xhero/powerbook100-airtalk/PowerBook100_AirTalk.kicad_pcb

## KiCad design PowerBook100_AirTalk.kicad_pcb (2023-10-18)

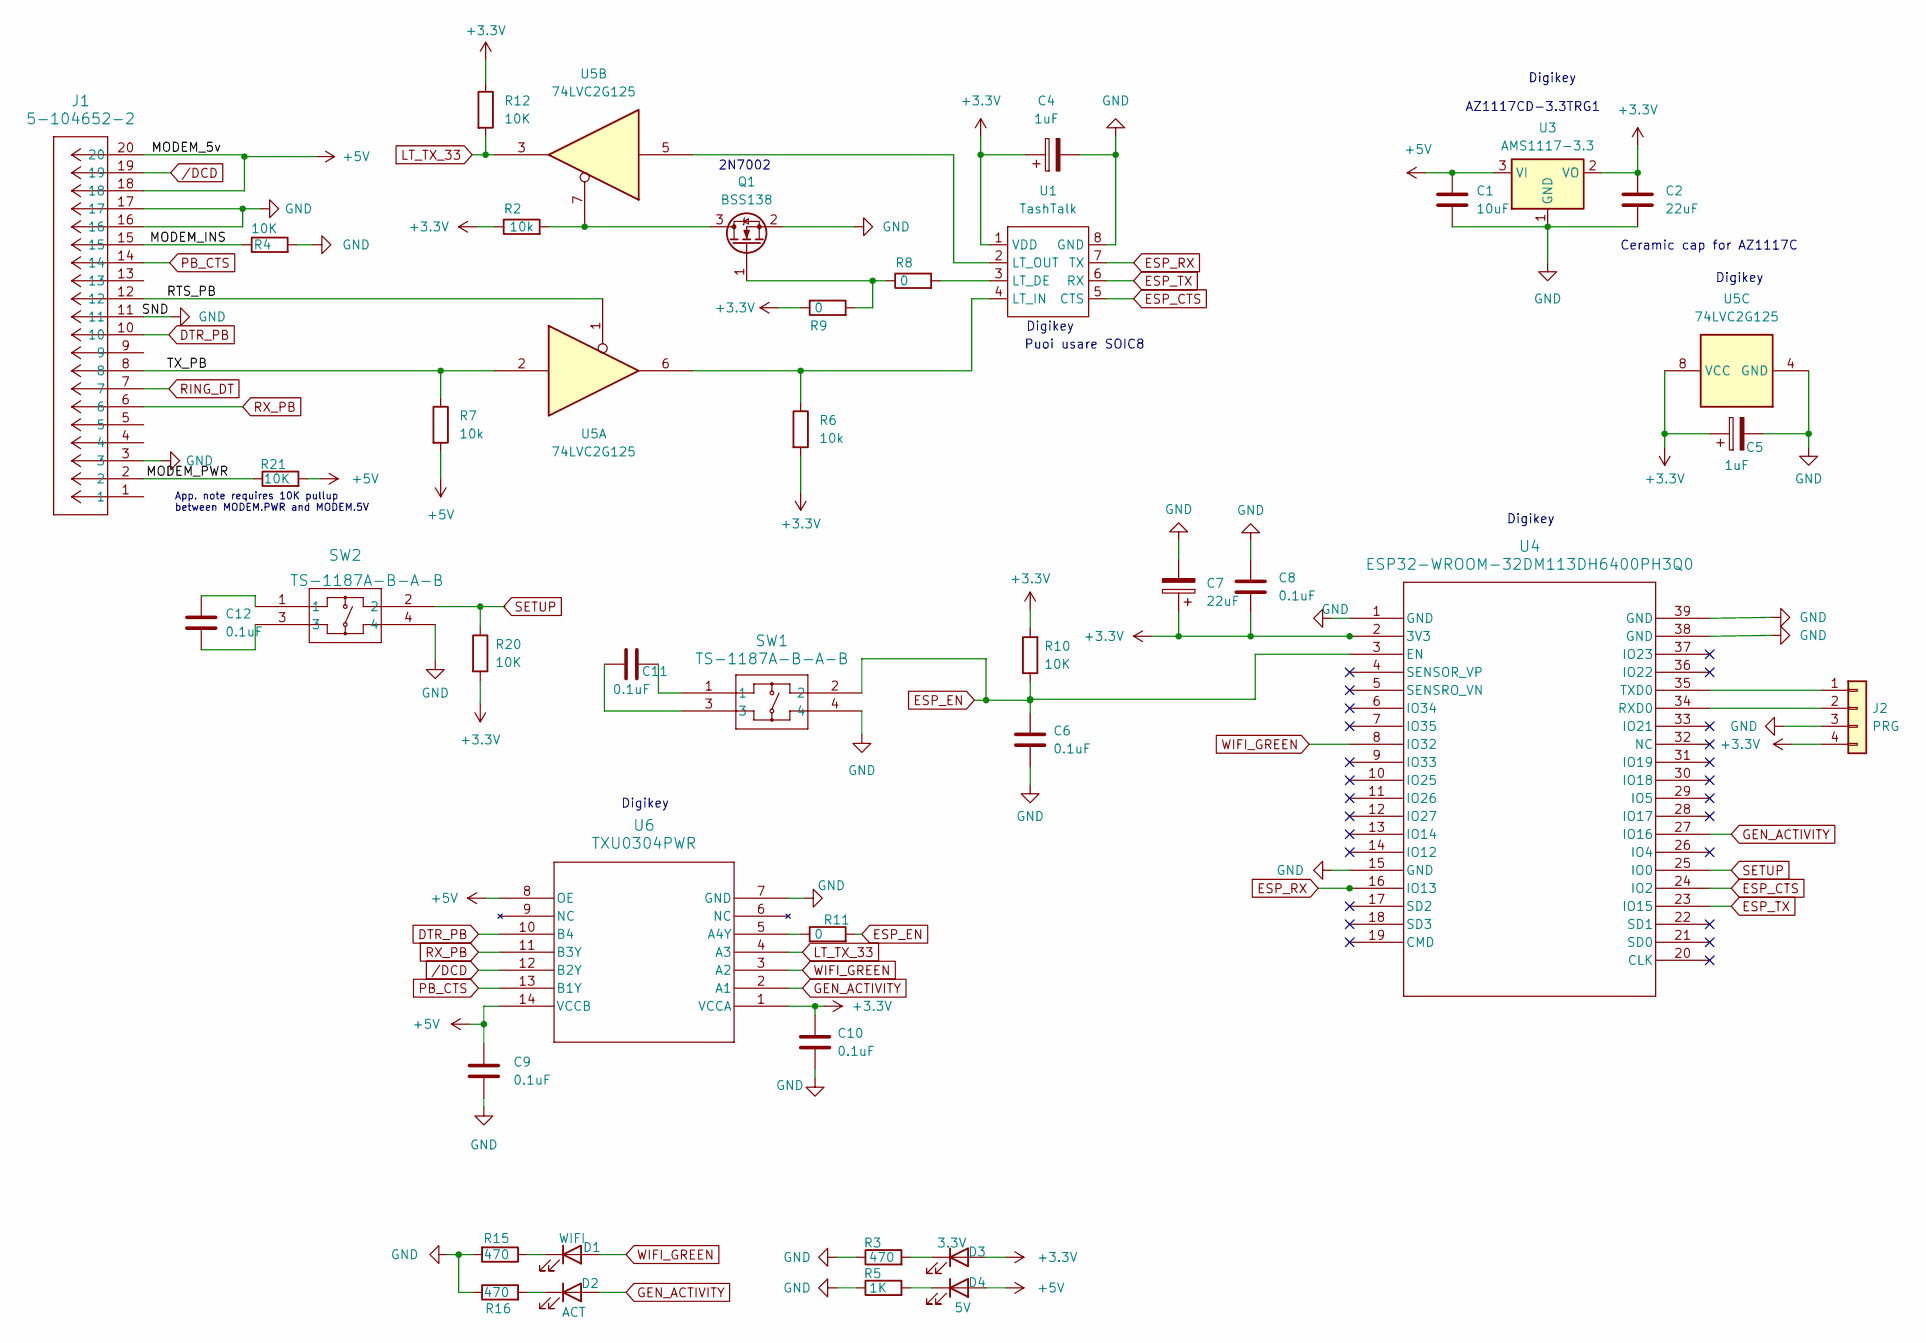
[picture p1: schematic PowerBook100_AirTalk.kicad_sch]

Parts:
C1: 10uF; C_0805_2012Metric
C2: 22uF; C_0805_2012Metric
C4, C5: 1uF; C_1206_3216Metric
C6, C8, C9, C10: 0.1uF; C_0805_2012Metric
C7: 22uF; C_1206_3216Metric
C11, C12: 0.1uF; C_1206_3216Metric
D1: WIFI; LED_0805_2012Metric
D2: ACT; LED_0805_2012Metric
D3: 3.3V; LED_0805_2012Metric
D4: 5V; LED_0805_2012Metric
J1: 5-104652-2; CONN_5-104652-2_TYCO
J2: PRG; PinHeader_1x04_P1.00mm_Vertical_SMD_Pin1Right
Q1: BSS138; SOT-23
R2, R6, R7: 10k; R_0805_2012Metric
R3, R15, R16: 470; R_0805_2012Metric
R4, R10, R12, R20, R21: 10K; R_0805_2012Metric
R5: 1K; R_0805_2012Metric
R8, R9, R11: 0; R_0805_2012Metric
SW1, SW2: TS-1187A-B-A-B; SW_Push_1P1T_XKB_TS-1187A
U1: TashTalk; SOIC-8_3.9x4.9mm_P1.27mm
U3: AMS1117-3.3; TO-252-3_TabPin2
U4: ESP32-WROOM-32DM113DH6400PH3Q0; ESP32-WROOM-32D
U5: 74LVC2G125; TSSOP-8_3x3mm_P0.65mm
U6: TXU0304PWR; TSSOP14_PW_TEX

Connections:
+3.3V: C2.1, C4.1, C5.1, C7.1, C8.2, C10.1, D3.2 (A), J2.4, R2.1, R6.2, R9.1, R10.2, R12.1, R20.2, U1.1 (VDD), U3.2 (VO), U4.2 (3V3), U5.8 (VCC), U6.1 (VCCA)
+5V: C1.1, C9.1, D4.2 (A), J1.18, J1.20, R7.2, R21.2, U3.3 (VI), U6.8 (OE), U6.14 (VCCB)
/MODEM_INS: J1.15, R4.1
/MODEM_PWR: J1.2, R21.1
/RTS_PB: J1.12, U5.1
/TX_PB: J1.8, R7.1, U5.2
DTR_PB: J1.10, U6.10 (B4)
ESP_CTS: U1.5 (CTS), U4.24 (IO2)
ESP_EN: C6.2, R10.1, R11.2, SW1.2, U4.3 (EN)
ESP_RX: U1.7 (TX), U4.16 (IO13)
ESP_TX: U1.6 (RX), U4.23 (IO15)
GEN_ACTIVITY: D2.2 (A), U4.27 (IO16), U6.2 (A1)
GND: C1.2, C2.2, C4.2, C5.2, C6.1, C7.2, C8.1, C9.2, C10.2, J1.3, J1.11, J1.16, J1.17, J2.3, Q1.2 (S), R3.1, R4.2, R5.1, R15.2, R16.1, SW1.4, SW2.4, U1.8 (GND), U3.1 (GND), U4.1 (GND), U4.15 (GND), U4.38 (GND), U4.39 (GND), U5.4 (GND), U6.7 (GND)
LT_TX_33: R12.2, U5.3, U6.4 (A3)
unnamed: C11.1, SW1.3
unnamed: C11.2, SW1.1
unnamed: C12.1, SW2.1
unnamed: C12.2, SW2.3
unnamed: D1.1 (K), R15.1
unnamed: D2.1 (K), R16.2
unnamed: D3.1 (K), R3.2
unnamed: D4.1 (K), R5.2
unnamed: J2.1, U4.35 (TXD0)
unnamed: J2.2, U4.34 (RXD0)
unnamed: Q1.3 (D), R2.2, U5.7
unnamed: Q1.1 (G), R8.1, R9.2
unnamed: R8.2, U1.3 (LT_DE)
unnamed: R6.1, U1.4 (LT_IN), U5.6
unnamed: U1.2 (LT_OUT), U5.5
unnamed: R11.1, U6.5 (A4Y)
PB_CTS: J1.14, U6.13 (B1Y)
RING_DT: J1.7
RX_PB: J1.6, U6.11 (B3Y)
SETUP: R20.1, SW2.2, U4.25 (IO0)
WIFI_GREEN: D1.2 (A), U4.8 (IO32), U6.3 (A2)
/DCD: J1.19, U6.12 (B2Y)

Notes on the sheet:
Digikey
Puoi usare SOIC8
App. note requires 10K pullup between MODEM.PWR and MODEM.5V
AZ1117CD-3.3TRG1
2N7002
Ceramic cap for AZ1117C

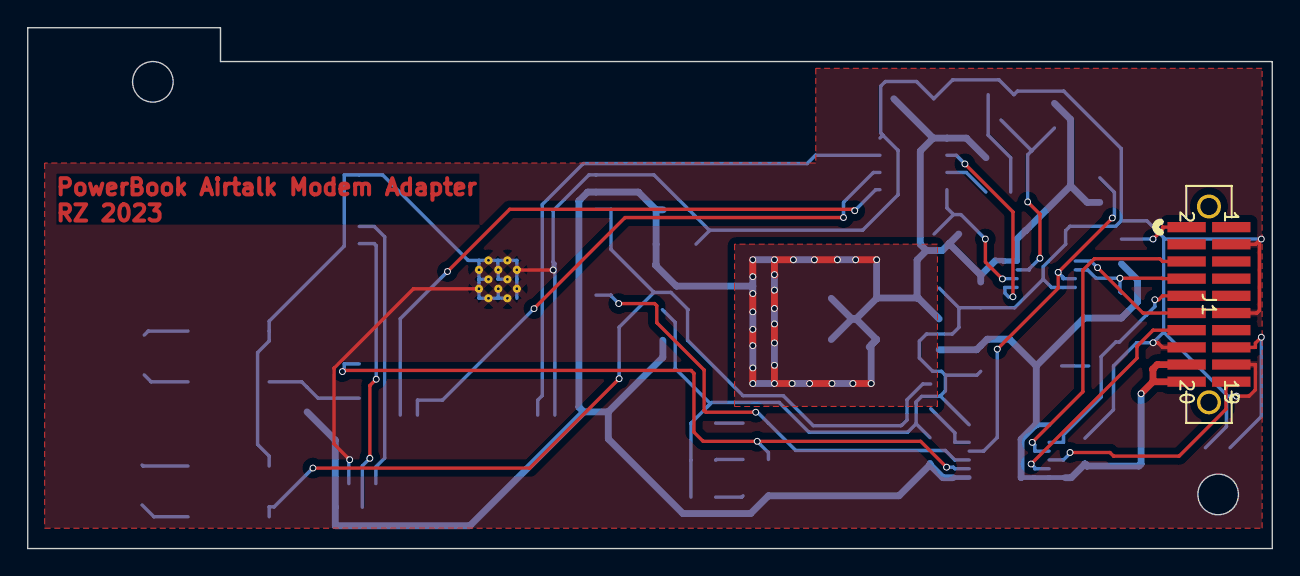
[picture p2: board PowerBook100_AirTalk.kicad_pcb from above]

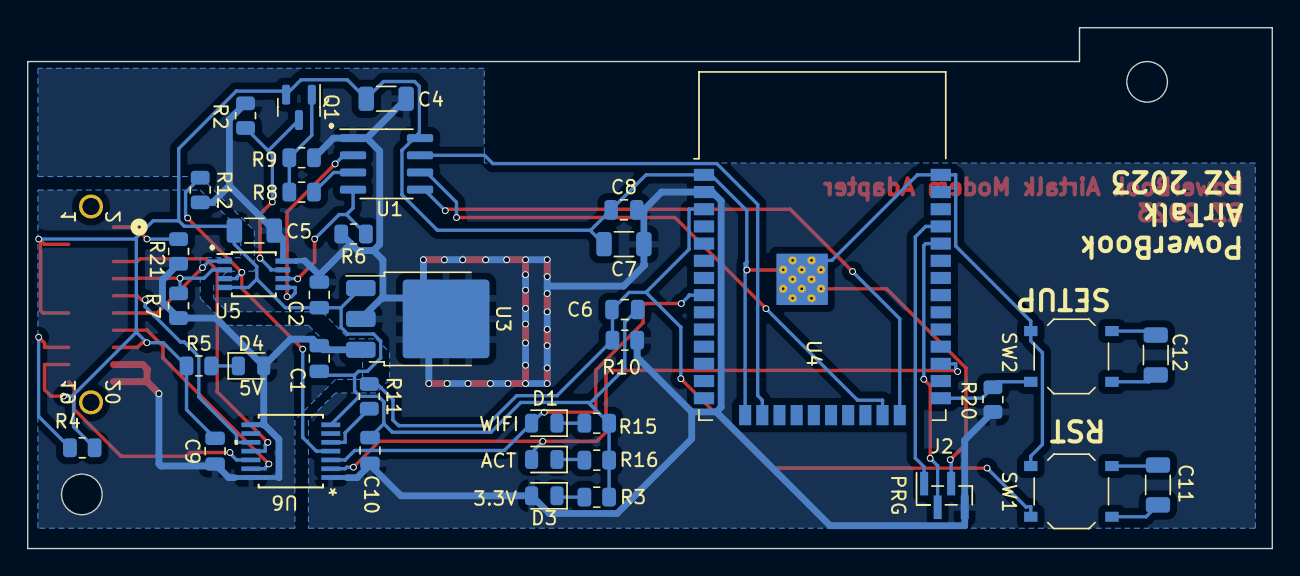
[picture p3: board PowerBook100_AirTalk.kicad_pcb from below]

Board: 2 copper layers, 92.0 x 38.5 mm, 40 parts (39 on the bottom side), 35 nets.
