xhero/powerbook100-airtalk/(commit log)

2023-08-12 New files
    [PowerBook100_AirTalk.csv, PowerBook100_AirTalk.kicad_pcb, PowerBook100_AirTalk.kicad_sch]
2023-08-16 More mods
    [PowerBook100_AirTalk.csv, PowerBook100_AirTalk.kicad_pcb, PowerBook100_AirTalk.kicad_sch]
2023-08-29 Add PCB layout
    [PowerBook100_AirTalk.kicad_pcb, PowerBook100_AirTalk.kicad_sch]
2023-09-03 Add proper dimensions
    [PowerBook100_AirTalk.kicad_pcb]
2023-10-18 New revision
    [PowerBook100_AirTalk.csv, PowerBook100_AirTalk.kicad_pcb, PowerBook100_AirTalk.kicad_sch]
2023-10-18 Add production files for v2
    [bom.csv, designators.csv, positions.csv]
2024-02-11 Add footprint
